nikethLakshmanan/Tokenizer/firmware/0.bmp

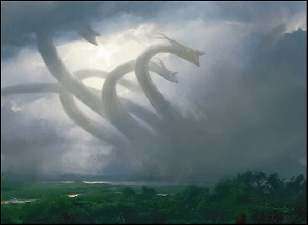
firmware/0.bmp
