nikethLakshmanan/Tokenizer/(list of files, cad)

Other CAD files:
enclosure/Button+Extension.f3d
enclosure/Screen.f3d
enclosure/Tokenizer+Enclosure.f3z
enclosure/USB4085-GF-A.f3d
enclosure/tokenizer.f3z
