nikethLakshmanan/Tokenizer/hardware/tokenizer.kicad_pcb

## KiCad design hardware/tokenizer.kicad_pcb (2024-12-11)

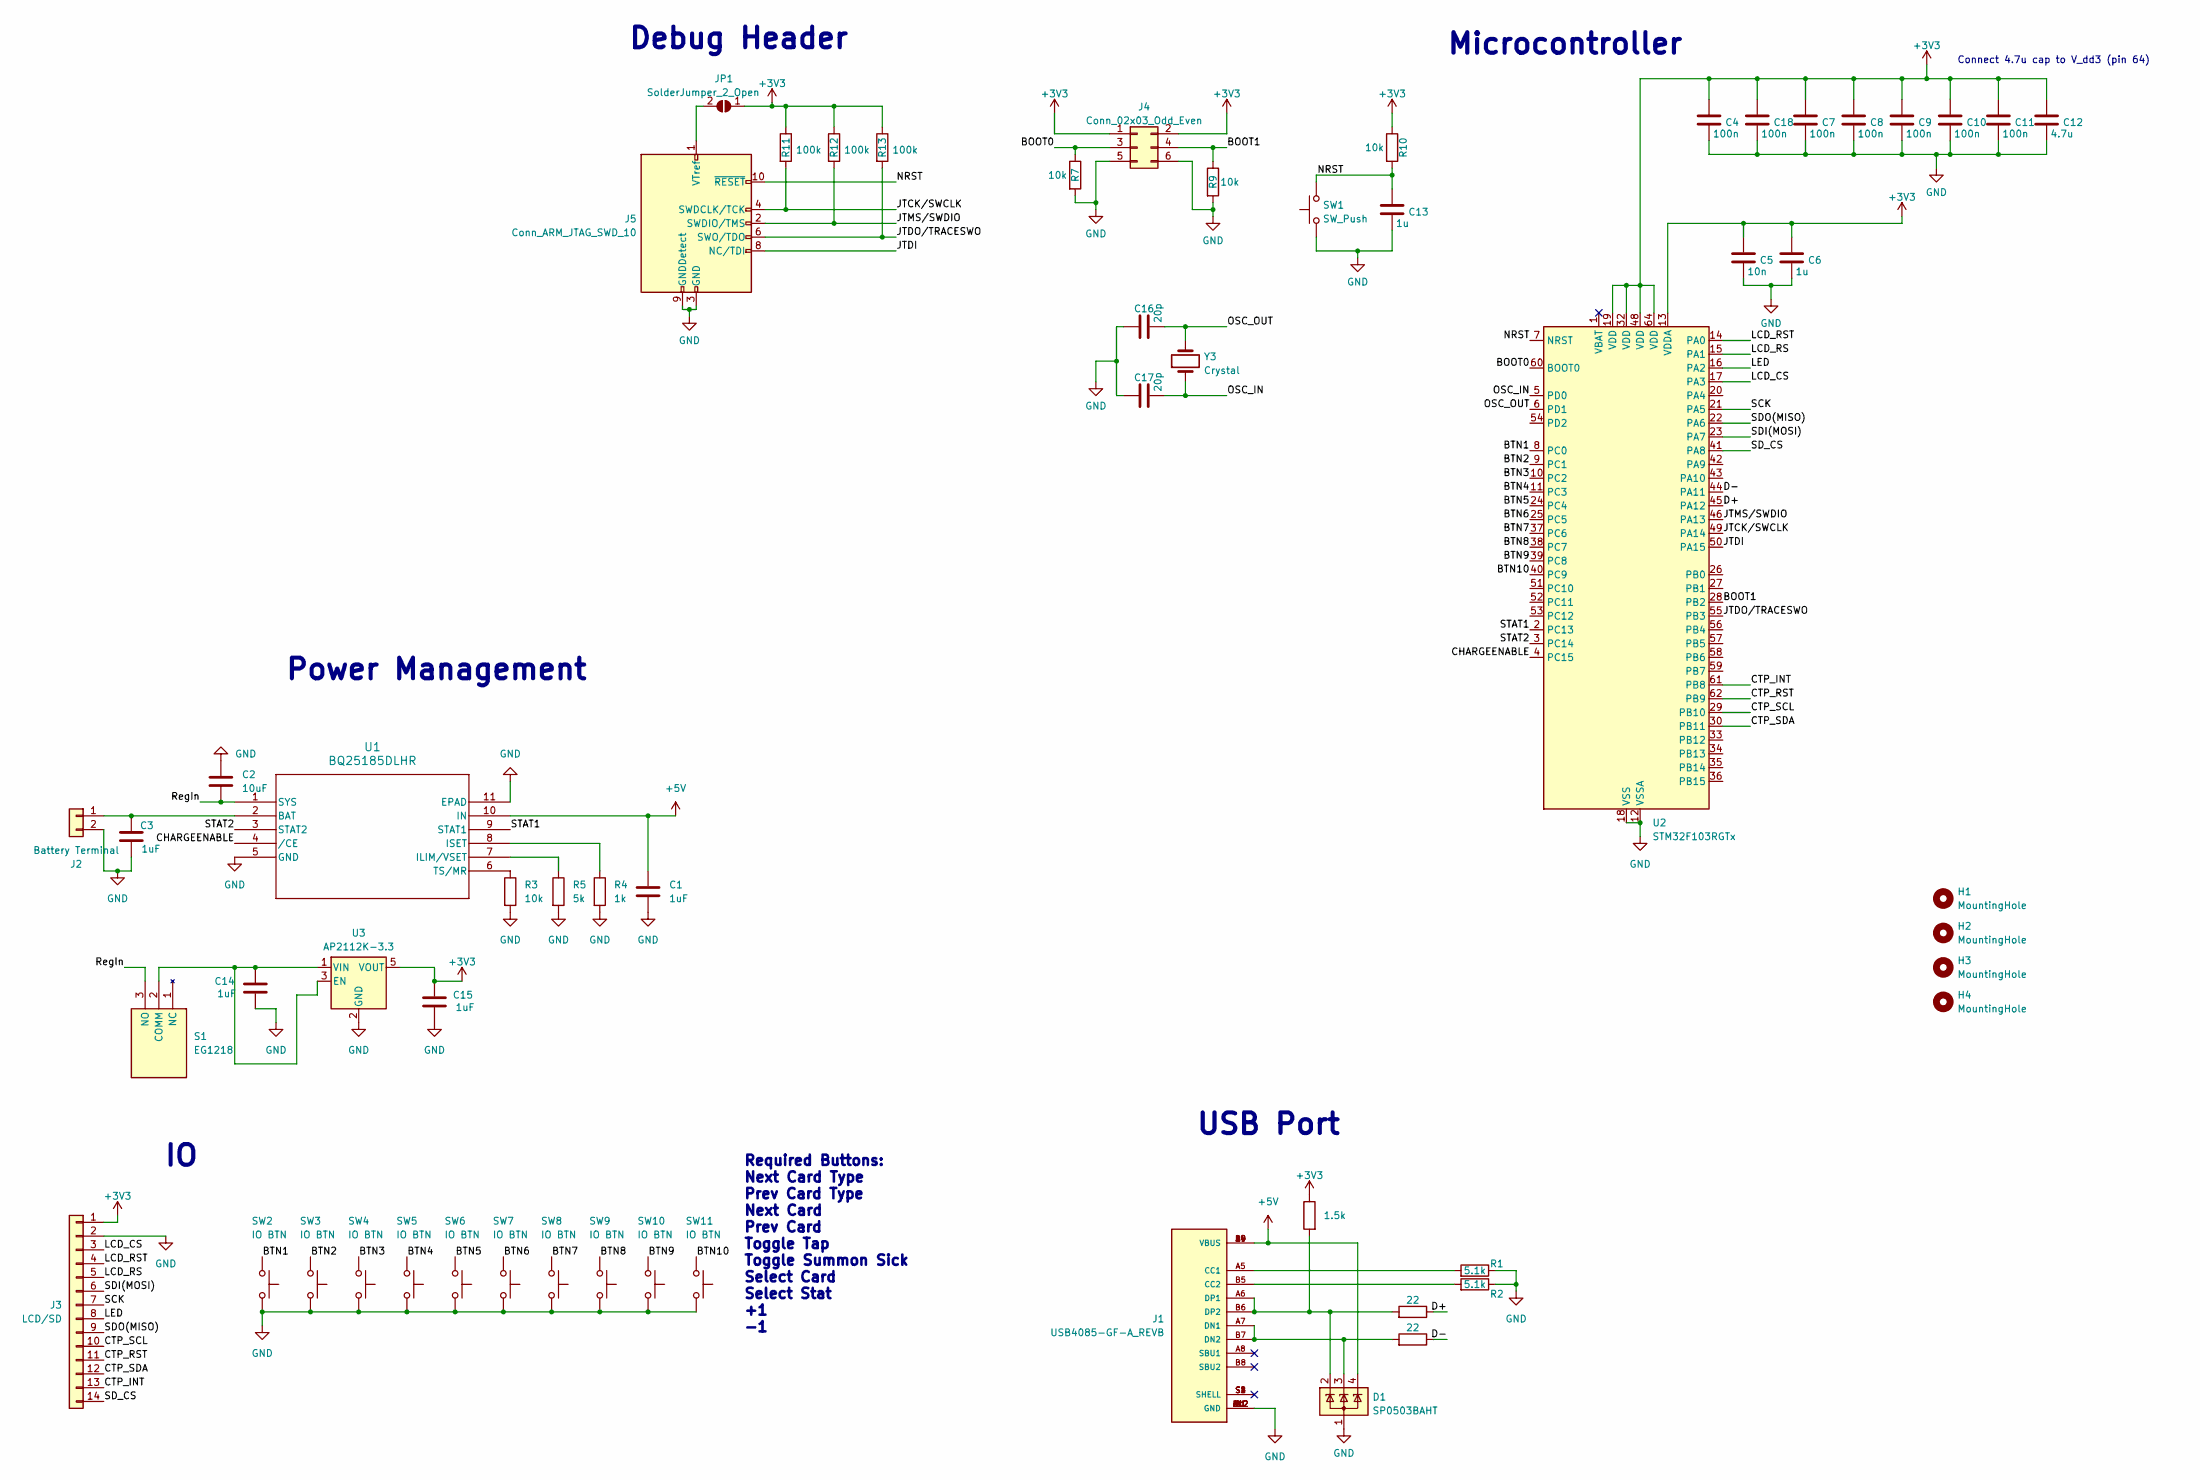
[picture p10: schematic tokenizer.kicad_sch]

Parts:
C1, C3, C14, C15: 1uF; C_0805_2012Metric_Pad1.18x1.45mm_HandSolder
C2: 10uF; C_0805_2012Metric_Pad1.18x1.45mm_HandSolder
C4, C7, C8, C9, C10, C11, C18: 100n; C_0603_1608Metric
C5: 10n; C_0603_1608Metric
C6, C13: 1u; C_0603_1608Metric
C12: 4.7u; C_0603_1608Metric
C16, C17: 20p; C_0603_1608Metric
D1: SP0503BAHT; SOT-143
H1, H2, H3, H4: MountingHole; MountingHole_3.2mm_M3
J1: USB4085-GF-A_REVB; GCT_USB4085-GF-A_REVB; PARTREV B
J2: Battery Terminal; JST_PH_S2B-PH-K_1x02_P2.00mm_Horizontal
J3: LCD/SD; Hirose_FH12-14S-0.5SH_1x14-1MP_P0.50mm_Horizontal
J4: Conn_02x03_Odd_Even; PinSocket_2x03_P2.54mm_Vertical
J5: Conn_ARM_JTAG_SWD_10; IDC-Header_2x05_P2.54mm_Vertical
JP1: SolderJumper_2_Open; SolderJumper-2_P1.3mm_Open_TrianglePad1.0x1.5mm
R1, R2: 5.1k; R_0805_2012Metric_Pad1.20x1.40mm_HandSolder
R3: 10k; R_0805_2012Metric_Pad1.20x1.40mm_HandSolder
R4: 1k; R_0805_2012Metric_Pad1.20x1.40mm_HandSolder
R5: 5k; R_0805_2012Metric_Pad1.20x1.40mm_HandSolder
R6, R8: 22; R_0603_1608Metric
R7, R9, R10: 10k; R_0603_1608Metric
R11, R12, R13: 100k; R_0603_1608Metric
R14: 1.5k; R_0603_1608Metric
S1: EG1218; Mouser Part Number 612-EG1218
SW1: SW_Push; SW_PUSH_6mm_H4.3mm
SW2, SW3, SW4, SW5, SW6, SW7, SW8, SW9, SW10, SW11: IO BTN; SW_PUSH_6mm_H4.3mm
U1: BQ25185DLHR; WSON10_DLH_TEX
U2: STM32F103RGTx; LQFP-64_10x10mm_P0.5mm
U3: AP2112K-3.3; SOT-23-5
Y3: Crystal; Crystal_HC49-U_Vertical

Connections:
+3V3: C4.1, C5.1, C6.1, C7.1, C8.1, C9.1, C10.1, C11.1, C12.1, C15.1, C18.1, J3.1, J4.1, J4.2, JP1.1 (A), R10.1, R11.1, R12.1, R13.1, R14.1, U2.13 (VDDA), U2.19 (VDD), U2.32 (VDD), U2.48 (VDD), U2.64 (VDD), U3.5 (VOUT)
+5V: C1.2, D1.4 (K), J1.A4 (VBUS), J1.A9 (VBUS), J1.B4 (VBUS), J1.B9 (VBUS), U1.10 (IN)
/BOOT0: J4.3, R7.1, U2.60 (BOOT0)
/BOOT1: J4.4, R9.1, U2.28 (PB2)
/BTN1: SW2.1, U2.8 (PC0)
/BTN2: SW3.1, U2.9 (PC1)
/BTN3: SW4.1, U2.10 (PC2)
/BTN4: SW5.1, U2.11 (PC3)
/BTN5: SW6.1, U2.24 (PC4)
/BTN6: SW7.1, U2.25 (PC5)
/BTN7: SW8.1, U2.37 (PC6)
/BTN8: SW9.1, U2.38 (PC7)
/BTN9: SW10.1, U2.39 (PC8)
/BTN10: SW11.1, U2.40 (PC9)
/CHARGEENABLE: U1.4 (/CE), U2.4 (PC15)
/CTP_INT: J3.13, U2.61 (PB8)
/CTP_RST: J3.11, U2.62 (PB9)
/CTP_SCL: J3.10, U2.29 (PB10)
/CTP_SDA: J3.12, U2.30 (PB11)
/D+: R6.1, U2.45 (PA12)
/D-: R8.1, U2.44 (PA11)
/JTCK/SWCLK: J5.4 (SWDCLK/TCK), R11.2, U2.49 (PA14)
/JTDI: J5.8 (NC/TDI), U2.50 (PA15)
/JTDO/TRACESWO: J5.6 (SWO/TDO), R13.2, U2.55 (PB3)
/JTMS/SWDIO: J5.2 (SWDIO/TMS), R12.2, U2.46 (PA13)
/LCD_CS: J3.3, U2.17 (PA3)
/LCD_RS: J3.5, U2.15 (PA1)
/LCD_RST: J3.4, U2.14 (PA0)
/LED: J3.8, U2.16 (PA2)
/NRST: C13.1, J5.10 (~RESET), R10.2, SW1.2, U2.7 (NRST)
/OSC_IN: C17.2, U2.5 (PD0), Y3.1
/OSC_OUT: C16.2, U2.6 (PD1), Y3.2
/RegIn: C2.1, S1.3 (NO), U1.1 (SYS)
/SCK: J3.7, U2.21 (PA5)
/SDI(MOSI): J3.6, U2.23 (PA7)
/SDO(MISO): J3.9, U2.22 (PA6)
/SD_CS: J3.14, U2.41 (PA8)
/STAT1: U1.9 (STAT1), U2.2 (PC13)
/STAT2: U1.3 (STAT2), U2.3 (PC14)
GND: C1.1, C2.2, C3.1, C4.2, C5.2, C6.2, C7.2, C8.2, C9.2, C10.2, C11.2, C12.2, C13.2, C14.2, C15.2, C16.1, C17.1, C18.2, D1.1 (A), J1.A1 (GND), J1.A12 (GND), J1.B1 (GND), J1.B12 (GND), J2.2, J3.2, J4.5, J4.6, J5.3 (GND), J5.5 (GND), J5.9 (GNDDetect), R1.1, R2.1, R3.2, R4.2, R5.2, R7.2, R9.2, SW1.1, SW2.2, SW3.2, SW4.2, SW5.2, SW6.2, SW7.2, SW8.2, SW9.2, SW10.2, SW11.2, U1.5 (GND), U1.11 (EPAD), U2.12 (VSSA), U2.18 (VSS), U2.31 (VSS), U2.47 (VSS), U2.63 (VSS), U3.2 (GND)
unnamed: J1.A5 (CC1), R1.2
unnamed: J1.B5 (CC2), R2.2
unnamed: D1.3 (K), J1.A7 (DN1), J1.B7 (DN2), R8.2
unnamed: D1.2 (K), J1.A6 (DP1), J1.B6 (DP2), R6.2, R14.2
unnamed: C3.2, J2.1, U1.2 (BAT)
unnamed: J5.1 (VTref), JP1.2 (B)
unnamed: C14.1, S1.2 (COMM), U3.1 (VIN), U3.3 (EN)
unnamed: R5.1, U1.7 (ILIM/VSET)
unnamed: R4.1, U1.8 (ISET)
unnamed: R3.1, U1.6 (TS/MR)

Notes on the sheet:
Connect 4.7u cap to V_dd3 (pin 64)
USB Port
Power Management
Required Buttons: Next Card Type Prev Card Type Next Card Prev Card Toggle Tap Toggle Summon Sick Select Card Select Stat +1 -1
Microcontroller
Debug Header

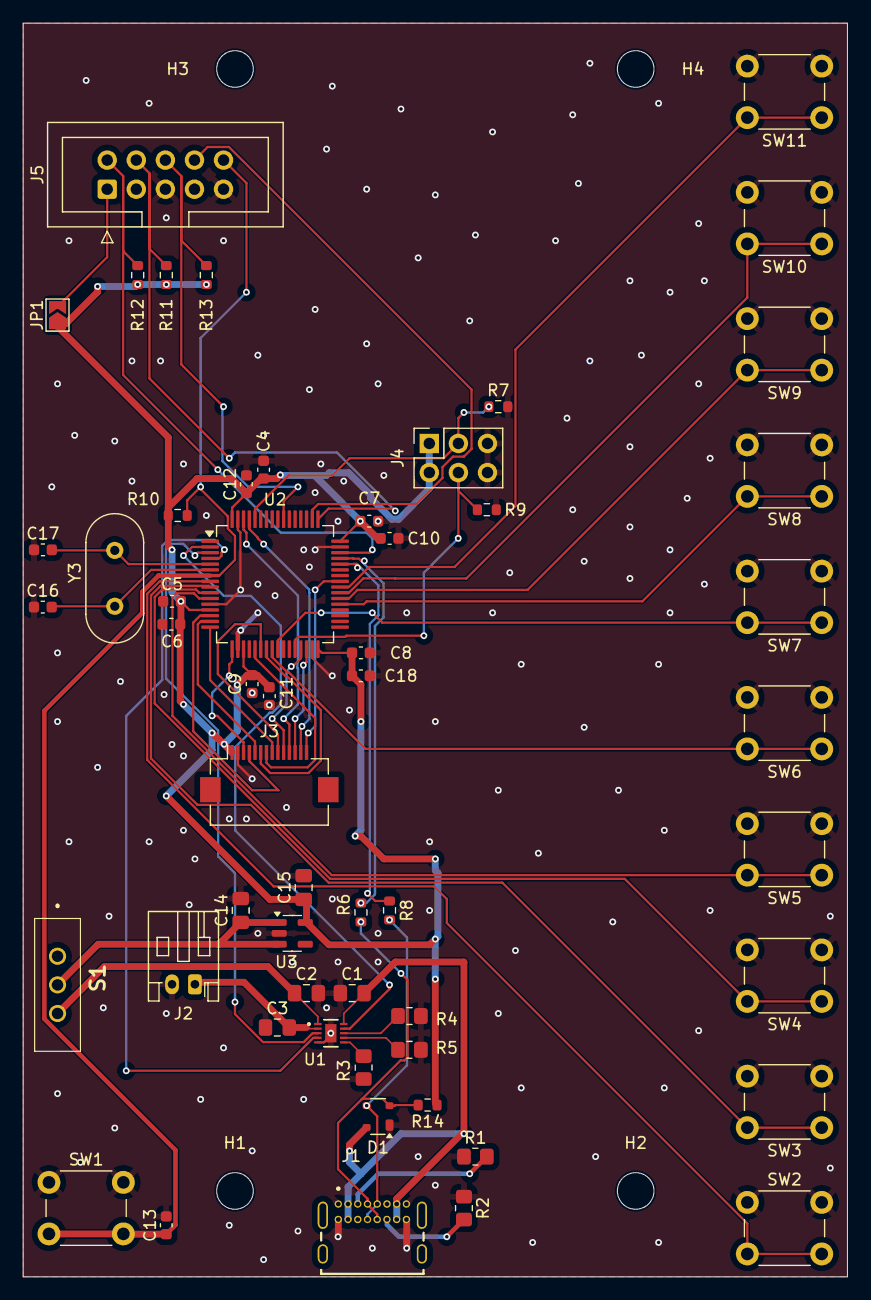
[picture p11: board tokenizer.kicad_pcb from above]

Board: 2 copper layers, 72.0 x 109.5 mm, 59 parts (0 on the bottom side), 50 nets.
