nikethLakshmanan/Tokenizer/firmware/include/pindefs.h

#ifndef PINDEFS_H
#define PINDEFS_H

#define TFT_CS PA_3
#define TFT_DC PA_1
#define TFT_RST PA_0
#define TFT_LED PA_2
#define SD_CS PA_8

#define BUTTON_PIN(n) PC_##n

#define STAT1 PC_13
#define STAT2 PC_14
#define CHARGE_EN PC_15

#endif
