nikethLakshmanan/Tokenizer/(commit log)

2024-12-11 Add firmware and hardware
    [tokenizer-B_Cu.gbr, tokenizer-B_Mask.gbr, tokenizer-B_Paste.gbr, tokenizer-B_Silkscreen.gbr, tokenizer-Edge_Cuts.gbr, tokenizer-F_Cu.gbr, tokenizer-F_Mask.gbr, tokenizer-F_Paste.gbr]
2024-12-11 Notebook copy from private repo, include enclosure files
    [Button+Extension.f3d, Screen.f3d, Tokenizer+Enclosure.f3z, USB4085-GF-A.f3d, tokenizer.f3z]
